ucw-gadgets/usb-rs485_switch/README.md

# usb-rs485_switch
8x RS-485 switch and USB convertor
