ucw-gadgets/usb-rs485_switch/hw/usb-rs485_switch/usb-rs485_switch.kicad_pcb

## KiCad design hw/usb-rs485_switch/usb-rs485_switch.kicad_pcb (2022-01-27)

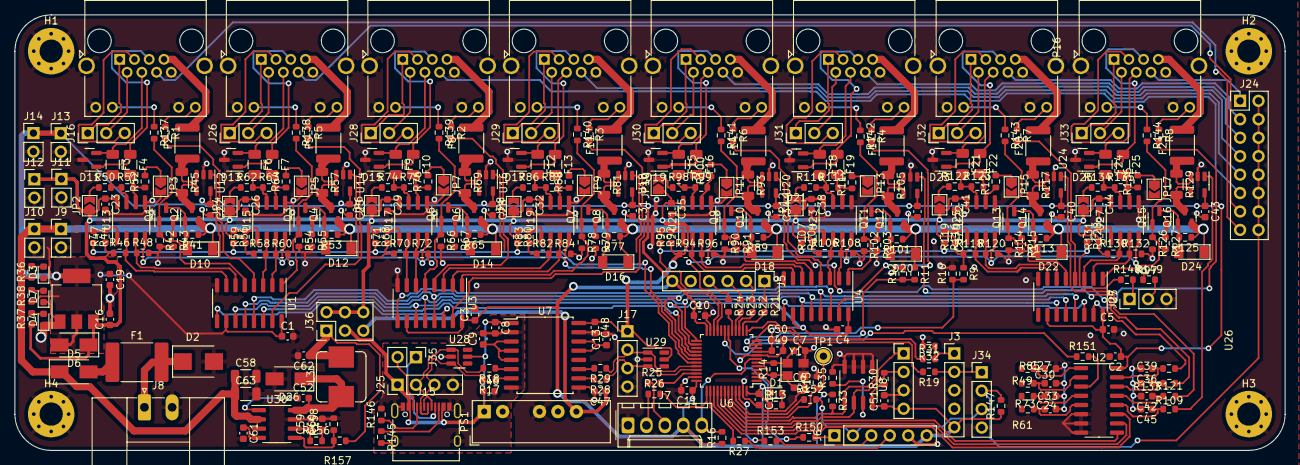
[picture p1: board usb-rs485_switch.kicad_pcb from above]

Board: 2 copper layers, 175.0 x 60.0 mm, 357 parts (0 on the bottom side), 279 nets.

Parts:
C1, C2, C3, C4, C5, C8, C9, C10, C11, C12, C13, C22, C23, C24, C25, C26, C27, C28, C29, C30, C31, C32, C33, C34, C35, C36, C37, C38, C39, C40, C41, C42, C43, C44, C45, C48, C49, C51, C52: 100n; C_0603_1608Metric
C6, C7: C; C_0603_1608Metric
C16, C47: 10u; C_0603_1608Metric
C19: 22u; C_0603_1608Metric
C46: 4u7; C_0603_1608Metric
C50: 1u; C_0603_1608Metric
C58, C63: 4u7/50V; C_1206_3216Metric
C59, C61: 8.2n; C_0603_1608Metric
C60: 22n; C_0603_1608Metric
C62: 22u/6.3V X5R; C_0603_1608Metric
D1: USR_LED; LED_0603_1608Metric
D2: SM6T27A; D_SMB
D3: VCC_LED; LED_0603_1608Metric
D4: 5V_LED; LED_0603_1608Metric
D5, D6: SS54; D_SMA
D7: 3V3_LED; LED_0603_1608Metric
D10, D12, D14, D16, D18, D20, D22, D24: ZMM5V6; D_MiniMELF
D11, D13, D15, D17, D19, D21, D23, D25: PSM712-LF-T7; SOT-23
D26: SS14; D_SMA
F1: Polyfuse; Fuse_2920_7451Metric
F2, F5, F8, F11, F14, F17, F20, F23: BSMD1812-110-33V; Fuse_1812_4532Metric
F3, F4, F6, F7, F9, F10, F12, F13, F15, F16, F18, F19, F21, F22, F24, F25: BSMD1206-010-60V; Fuse_1206_3216Metric
H1, H2, H3, H4: MountingHole_Pad; MountingHole_3.2mm_M3_Pad_Via
J1, J2, J18, J19, J20, J21, J22, J23: RJ45_LED_Shielded; RJ45_Amphenol_RJHSE538X
J3: USART2; PinHeader_1x05_P2.54mm_Vertical
J4: I2C; PinHeader_1x04_P2.54mm_Vertical
J5: SPI; PinHeader_1x06_P2.54mm_Vertical
J6: GPIO; PinHeader_1x06_P2.54mm_Vertical
J7: PROG; Molex_KK-254_AE-6410-05A_1x05_P2.54mm_Vertical
J8: POWER; PhoenixContact_MC_1,5_2-GF-3.81_1x02_P3.81mm_Horizontal_Thr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
J9: VCC_OUT1; PinHeader_1x02_P2.54mm_Vertical
J10: VCC_OUT2; PinHeader_1x02_P2.54mm_Vertical
J11: 5V_OUT1; PinHeader_1x02_P2.54mm_Vertical
J12: 5V_OUT2; PinHeader_1x02_P2.54mm_Vertical
J13: 3V_OUT1; PinHeader_1x02_P2.54mm_Vertical
J14: 3V3_OUT2; PinHeader_1x02_P2.54mm_Vertical
J15: MC-107DM; USB_C_Receptacle_XKB_U262-16XN-4BVC11
J16: RES1; PinHeader_1x03_P2.54mm_Vertical
J17: USB_NONISO; PinHeader_1x04_P2.54mm_Vertical
J24: 1WIRE_CHANNELS; PinHeader_2x08_P2.54mm_Vertical
J25: USB_ISO; PinHeader_1x04_P2.54mm_Vertical
J26: RES2; PinHeader_1x03_P2.54mm_Vertical
J27: USART3; PinHeader_1x03_P2.54mm_Vertical
J28: RES3; PinHeader_1x03_P2.54mm_Vertical
J29: RES4; PinHeader_1x03_P2.54mm_Vertical
J30: RES5; PinHeader_1x03_P2.54mm_Vertical
J31: RES6; PinHeader_1x03_P2.54mm_Vertical
J32: RES7; PinHeader_1x03_P2.54mm_Vertical
J33: RES8; PinHeader_1x03_P2.54mm_Vertical
J34: 1WIRE_SELECT; PinHeader_1x04_P2.54mm_Vertical
J35: USB-C_SBU; PinHeader_1x02_P2.54mm_Vertical
J36: PWR_SELECT; PinHeader_2x03_P2.54mm_Vertical
JP2, JP3, JP4, JP5, JP6, JP7, JP8, JP9, JP10, JP11, JP12, JP13, JP14, JP15, JP16, JP17: SolderJumper_2_Open; SolderJumper-2_P1.3mm_Open_TrianglePad1.0x1.5mm
L3: 47u; L_Bourns_SRP7028A_7.3x6.6mm
PS1: IA0505S; Converter_DCDC_XP_POWER-IAxxxxS_THT
Q1, Q3, Q5, Q7, Q9, Q11, Q13, Q15: MMBT5551; SOT-23
Q2, Q4, Q6, Q8, Q10, Q12, Q14, Q16: Si2301CDS; SOT-23
R1, R2, R3, R4, R5, R6, R7, R8, R41, R53, R65, R77, R89, R101, R113, R125: 1k; R_0603_1608Metric
R9, R10, R11, R12, R13, R14, R15, R16, R31, R32, R35, R36, R37, R38, R148, R149, R156, R157, R158: R; R_0603_1608Metric
R17, R18, R28, R29: 24R; R_0603_1608Metric
R19, R21, R22, R23, R24, R25, R26, R27, R44, R56, R68, R80, R92, R104, R116, R128, R150, R151, R152, R153: 330R; R_0603_1608Metric
R30, R33, R147: 4k7; R_0603_1608Metric
R42, R46, R47, R48, R54, R58, R59, R60, R66, R70, R71, R72, R78, R82, R83, R84, R90, R94, R95, R96, R102, R106, R107, R108, R114, R118, R119, R120, R126, R130, R131, R132: 10k; R_0603_1608Metric
R43, R55, R67, R79, R91, R103, R115, R127, R137, R138, R139, R140, R141, R142, R143, R144: 2k7; R_0603_1608Metric
R45, R57, R69, R81, R93, R105, R117, R129: 0R1; R_1206_3216Metric
R49, R61, R73, R85, R97, R109, R121, R133: 100k; R_0603_1608Metric
R50, R52, R62, R64, R74, R76, R86, R88, R98, R100, R110, R112, R122, R124, R134, R136: 720R; R_0603_1608Metric
R51, R63, R75, R87, R99, R111, R123, R135: 120R; R_0603_1608Metric
R145, R146: 5k1; R_0603_1608Metric
TP1: BOOT0; TestPoint_THTPad_D2.0mm_Drill1.0mm
U1, U3, U4, U5: 74HC595; SOIC-16_3.9x9.9mm_P1.27mm
U2: CD4051B; SOIC-16_3.9x9.9mm_P1.27mm
U6: STM32F103C8Tx; LQFP-48_7x7mm_P0.5mm
U7: ADUM4160; SOIC-16W_7.5x10.3mm_P1.27mm
U8: M24C01-WMN; SOIC-8_3.9x4.9mm_P1.27mm
U11: AMS1117-3.3; SOT-223-3_TabPin2
U12, U14, U16, U18, U20, U22, U24, U26: INA180A1; SOT-23-5
U13, U15, U17, U19, U21, U23, U25, U27: MAX485E; SOIC-8_3.9x4.9mm_P1.27mm
U28, U29: SRV05-4; SOT-23-6
U30: TPS54331; SOIC-8_3.9x4.9mm_P1.27mm
Y1: Crystal_GND23; Crystal_SMD_3225-4Pin_3.2x2.5mm

Connections:
+3V3: C1.1, C2.1, C3.1, C4.1, C5.1, C10.1, C11.1, C12.1, C19.1, C22.1, C25.1, C28.1, C31.1, C34.1, C37.1, C40.1, C43.1, C49.1, C50.1, C51.1, D6.2 (A), J3.5, J4.4, J5.6, J6.6, J7.4, J13.1, J14.1, R13.1, R16.1, R30.1, R33.1, R38.1, R147.1, U1.10 (~SRCLR), U1.16 (VCC), U2.16 (VDD), U3.10 (~SRCLR), U3.16 (VCC), U4.10 (~SRCLR), U4.16 (VCC), U5.10 (~SRCLR), U5.16 (VCC), U6.9 (VDDA), U6.24 (VDD), U6.36 (VDD), U6.48 (VDD), U8.8 (VCC), U11.2 (VO), U12.5 (VS), U14.5 (VS), U16.5 (VS), U18.5 (VS), U20.5 (VS), U22.5 (VS), U24.5 (VS), U26.5 (VS)
+5V: C16.1, C23.1, C26.1, C29.1, C32.1, C35.1, C38.1, C41.1, C44.1, C48.1, D6.1 (K), J11.1, J12.1, J17.1, J36.2, J36.4, J36.6, JP2.1 (A), JP4.1 (A), JP6.1 (A), JP8.1 (A), JP10.1 (A), JP12.1 (A), JP14.1 (A), JP16.1 (A), R9.1, R37.1, R46.1, R47.1, R58.1, R59.1, R70.1, R71.1, R82.1, R83.1, R94.1, R95.1, R106.1, R107.1, R118.1, R119.1, R130.1, R131.1, U7.16 (VBUS2), U11.3 (VI), U13.8 (VCC), U15.8 (VCC), U17.8 (VCC), U19.8 (VCC), U21.8 (VCC), U23.8 (VCC), U25.8 (VCC), U27.8 (VCC), U29.5 (VP)
/1WIRE: J24.2, J24.4, J24.6, J24.8, J24.10, J24.12, J24.14, J24.16, J34.2, R147.2
/1WIRE1: J1.6, J24.15
/1WIRE2: J2.6, J24.13
/1WIRE3: J18.6, J24.11
/1WIRE4: J19.6, J24.9
/1WIRE5: J20.6, J24.7
/1WIRE6: J21.6, J24.5
/1WIRE7: J22.6, J24.3
/1WIRE8: J23.6, J24.1
/5V_DCDC: C62.1, J36.1, L3.2, R157.1
/5V_SENSE: R9.2, R10.1, U6.11 (PA1)
/5V_USB_ISO: C47.1, J36.5, PS1.6 (+Vout)
/GPIO0: J6.1, R150.2
/GPIO1: J6.2, J34.3, R152.2
/GPIO2: J6.3, R153.2
/GPIO3: J6.4, R27.1
/I2C1_SCL: J4.2, R30.2, U6.42 (PB6), U8.6 (SCL)
/I2C1_SDA: J4.1, R33.2, U6.43 (PB7), U8.5 (SDA)
/I_SENSE: R151.2, U2.3 (X)
/I_SENSE1: C24.1, R49.1, U2.1 (X4)
/I_SENSE2: C27.1, R61.1, U2.5 (X5)
/I_SENSE3: C30.1, R73.1, U2.2 (X6)
/I_SENSE4: C33.1, R85.1, U2.4 (X7)
/I_SENSE5: C36.1, R97.1, U2.15 (X2)
/I_SENSE6: C39.1, R109.1, U2.14 (X1)
/I_SENSE7: C42.1, R121.1, U2.13 (X0)
/I_SENSE8: C45.1, R133.1, U2.12 (X3)
/I_SEN_A: U2.11 (A), U6.39 (PB3)
/I_SEN_B: U2.10 (B), U6.40 (PB4)
/I_SEN_C: U2.9 (C), U6.41 (PB5)
/LED_G1: J1.12, R1.1
/LED_G2: J2.12, R5.1
/LED_G3: J18.12, R2.1
/LED_G4: J19.12, R3.1
/LED_G5: J20.12, R6.1
/LED_G6: J21.12, R4.1
/LED_G7: J22.12, R7.1
/LED_G8: J23.12, R8.1
/NRST: J7.5, R16.2, U6.7 (NRST)
/PWR_EN1: Q1.1 (B), R42.1, R137.2, U1.5 (QF)
/PWR_EN2: Q3.1 (B), R54.1, R138.2, U1.1 (QB)
/PWR_EN3: Q5.1 (B), R66.1, R139.2, U3.5 (QF)
/PWR_EN4: Q7.1 (B), R78.1, R140.2, U3.1 (QB)
/PWR_EN5: Q9.1 (B), R90.1, R141.2, U4.5 (QF)
/PWR_EN6: Q11.1 (B), R102.1, R142.2, U4.1 (QB)
/PWR_EN7: Q13.1 (B), R114.1, R143.2, U5.5 (QF)
/PWR_EN8: Q15.1 (B), R126.1, R144.2, U5.1 (QB)
/RS485 Line driver/A: D11.1 (A1), F4.1, J1.5
/RS485 Line driver/B: D11.2 (A2), F3.1, J1.4
/RS485 Line driver/PWR_OUT: F2.2, J1.7
/SPI1_MISO: J5.3, R23.1
/SPI1_MOSI: J5.4, R24.1
/SPI1_SCK: J5.2, R22.1
/SPI2_MOSI: U1.14 (SER), U6.28 (PB15)
/SPI2_SCK: U1.11 (SRCLK), U3.11 (SRCLK), U4.11 (SRCLK), U5.11 (SRCLK), U6.26 (PB13)
/SPI2_STROBE: U1.12 (RCLK), U3.12 (RCLK), U4.12 (RCLK), U5.12 (RCLK), U6.25 (PB12)
/SWCLK: J7.2, R26.1
/SWDIO: J7.3, R25.1
/TX_EN1: R48.1, U1.6 (QG), U13.3 (DE)
/TX_EN2: R60.1, U1.2 (QC), U15.3 (DE)
/TX_EN3: R72.1, U3.6 (QG), U17.3 (DE)
/TX_EN4: R84.1, U3.2 (QC), U19.3 (DE)
/TX_EN5: R96.1, U4.6 (QG), U21.3 (DE)
/TX_EN6: R108.1, U4.2 (QC), U23.3 (DE)
/TX_EN7: R120.1, U5.6 (QG), U25.3 (DE)
/TX_EN8: R132.1, U5.2 (QC), U27.3 (DE)
/USART1_RX: R44.2, R56.2, R68.2, R80.2, U6.31 (PA10)
/USART1_TX: U6.30 (PA9), U13.4 (DI), U15.4 (DI), U17.4 (DI), U19.4 (DI)
/USART2_RX: R31.1, U6.13 (PA3)
/USART2_TX: J3.2, J34.1, R19.1
/USART3_RX: R92.2, R104.2, R116.2, R128.2, R148.1, U6.22 (PB11)
/USART3_TX: R149.1, U6.21 (PB10), U21.4 (DI), U23.4 (DI), U25.4 (DI), U27.4 (DI)
/USB_DN: J17.2, R29.1, U6.32 (PA11), U29.1 (IO1)
/USB_DP: J17.3, R28.1, U6.33 (PA12), U29.3 (IO2)
/USB_IN_N: J15.A7 (D-), J15.B7 (D-), J25.2, R18.2, U28.1 (IO1)
/USB_IN_P: J15.A6 (D+), J15.B6 (D+), J25.3, R17.2, U28.3 (IO2)
/VCC_SENSE: R11.2, R12.1, U6.10 (PA0)
/sheet620AF7C7/A: D17.1 (A1), F13.1, J19.5
/sheet620AF7C7/B: D17.2 (A2), F12.1, J19.4
/sheet620AF7C7/PWR_OUT: F11.2, J19.7
/sheet620CBEF1/A: D19.1 (A1), F16.1, J20.5
/sheet620CBEF1/B: D19.2 (A2), F15.1, J20.4
/sheet620CBEF1/PWR_OUT: F14.2, J20.7
/sheet620CBEF2/A: D21.1 (A1), F19.1, J21.5
/sheet620CBEF2/B: D21.2 (A2), F18.1, J21.4
/sheet620CBEF2/PWR_OUT: F17.2, J21.7
/sheet620CBEF3/A: D23.1 (A1), F22.1, J22.5
/sheet620CBEF3/B: D23.2 (A2), F21.1, J22.4
/sheet620CBEF3/PWR_OUT: F20.2, J22.7
/sheet620CBEF4/A: D25.1 (A1), F25.1, J23.5
/sheet620CBEF4/B: D25.2 (A2), F24.1, J23.4
/sheet620CBEF4/PWR_OUT: F23.2, J23.7
/sheet6205AD21/A: D13.1 (A1), F7.1, J2.5
/sheet6205AD21/B: D13.2 (A2), F6.1, J2.4
/sheet6205AD21/PWR_OUT: F5.2, J2.7
/sheet62070CF7/A: D15.1 (A1), F10.1, J18.5
/sheet62070CF7/B: D15.2 (A2), F9.1, J18.4
/sheet62070CF7/PWR_OUT: F8.2, J18.7
/~RX_EN1: R46.2, U1.7 (QH), U13.2 (~RE)
/~RX_EN2: R58.2, U1.3 (QD), U15.2 (~RE)
/~RX_EN3: R70.2, U3.7 (QH), U17.2 (~RE)
/~RX_EN4: R82.2, U3.3 (QD), U19.2 (~RE)
/~RX_EN5: R94.2, U4.7 (QH), U21.2 (~RE)
/~RX_EN6: R106.2, U4.3 (QD), U23.2 (~RE)
/~RX_EN7: R118.2, U5.7 (QH), U25.2 (~RE)
/~RX_EN8: R130.2, U5.3 (QD), U27.2 (~RE)
/~SPI1_SS: J5.1, R21.1
/~SPI2_OE: U1.13 (~OE), U3.13 (~OE), U4.13 (~OE), U5.13 (~OE), U6.29 (PA8)
GND: C1.2, C2.2, C3.2, C4.2, C5.2, C6.2, C7.2, C10.2, C11.2, C12.2, C13.2, C16.2, C19.2, C22.2, C23.2, C24.2, C25.2, C26.2, C27.2, C28.2, C29.2, C30.2, C31.2, C32.2, C33.2, C34.2, C35.2, C36.2, C37.2, C38.2, C39.2, C40.2, C41.2, C42.2, C43.2, C44.2, C45.2, C47.2, C48.2, C49.2, C50.2, C51.2, C58.2, C59.2, C60.2, C61.2, C62.2, C63.2, D2.2 (A2), D3.1 (K), D4.1 (K), D7.1 (K), D11.3 (common), D13.3 (common), D15.3 (common), D17.3 (common), D19.3 (common), D21.3 (common), D23.3 (common), D25.3 (common), D26.2 (A), H1.1, H2.1, H3.1, H4.1, J1.8, J1.9, J1.11, J1.SH, J2.8, J2.9, J2.11, J2.SH, J3.3, J4.3, J5.5, J6.5, J7.1, J8.2, J9.2, J10.2, J11.2, J12.2, J13.2, J14.2, J17.4, J18.8, J18.9, J18.11, J18.SH, J19.8, J19.9, J19.11, J19.SH, J20.8, J20.9, J20.11, J20.SH, J21.8, J21.9, J21.11, J21.SH, J22.8, J22.9, J22.11, J22.SH, J23.8, J23.9, J23.11, J23.SH, J27.3, J34.4, JP3.2 (B), JP5.2 (B), JP7.2 (B), JP9.2 (B), JP11.2 (B), JP13.2 (B), JP15.2 (B), JP17.2 (B), PS1.4 (-Vout), R10.2, R12.2, R15.2, R32.2, R35.2, R42.2, R43.2, R48.2, R54.2, R55.2, R60.2, R66.2, R67.2, R72.2, R78.2, R79.2, R84.2, R90.2, R91.2, R96.2, R102.2, R103.2, R108.2, R114.2, R115.2, R120.2, R126.2, R127.2, R132.2, R158.2, U1.8 (GND), U2.6 (INH), U2.7 (VEE), U2.8 (VSS), U3.8 (GND), U4.8 (GND), U5.8 (GND), U6.8 (VSSA), U6.23 (VSS), U6.35 (VSS), U6.47 (VSS), U7.9 (GND2), U7.15 (GND2), U8.1 (E0), U8.2 (E1), U8.3 (E2), U8.4 (VSS), U11.1 (GND), U12.2 (GND), U13.5 (GND), U14.2 (GND), U15.5 (GND), U16.2 (GND), U17.5 (GND), U18.2 (GND), U19.5 (GND), U20.2 (GND), U21.5 (GND), U22.2 (GND), U23.5 (GND), U24.2 (GND), U25.5 (GND), U26.2 (GND), U27.5 (GND), U29.2 (VN), U30.7 (GND), Y1.2, Y1.3
GND2: C8.2, C9.2, C46.2, J15.A1 (GND), J15.A12 (GND), J15.B1 (GND), J15.B12 (GND), J15.S1 (SHIELD), J25.4, PS1.2 (-Vin), R145.2, R146.2, U7.2 (GND1), U7.8 (GND1), U28.2 (VN)
unnamed: C6.1, R14.1, U6.5 (PD0), Y1.1
unnamed: C7.1, R14.2, U6.6 (PD1), Y1.4
unnamed: C9.1, U7.3 (VDD1), U7.4 (PDEN), U7.5 (SPU)
unnamed: C13.1, U7.13 (SPD), U7.14 (VDD2)
unnamed: C52.2, D26.1 (K), L3.1, U30.8 (PH)
unnamed: C60.1, R156.2
unnamed: D1.1 (K), U6.2 (PC13)
unnamed: D1.2 (A), R13.2
unnamed: D2.1 (A1), F1.2, J8.1
unnamed: D3.2 (A), R36.2
unnamed: D4.2 (A), R37.2
unnamed: D5.2 (A), F1.1
unnamed: D7.2 (A), R38.2
unnamed: D10.2 (A), Q1.3 (C), Q2.1 (G), R41.2
unnamed: D12.2 (A), Q3.3 (C), Q4.1 (G), R53.2
unnamed: D14.2 (A), Q5.3 (C), Q6.1 (G), R65.2
unnamed: D16.2 (A), Q7.3 (C), Q8.1 (G), R77.2
unnamed: D18.2 (A), Q9.3 (C), Q10.1 (G), R89.2
unnamed: D20.2 (A), Q11.3 (C), Q12.1 (G), R101.2
unnamed: D22.2 (A), Q13.3 (C), Q14.1 (G), R113.2
unnamed: D24.2 (A), Q15.3 (C), Q16.1 (G), R125.2
unnamed: F2.1, R45.1, U12.3 (+)
unnamed: F3.2, R50.2, R51.1, U13.7 (B)
unnamed: F4.2, R51.2, R52.1, U13.6 (A)
unnamed: F5.1, R57.1, U14.3 (+)
unnamed: F6.2, R62.2, R63.1, U15.7 (B)
unnamed: F7.2, R63.2, R64.1, U15.6 (A)
unnamed: F8.1, R69.1, U16.3 (+)
unnamed: F9.2, R74.2, R75.1, U17.7 (B)
unnamed: F10.2, R75.2, R76.1, U17.6 (A)
unnamed: F11.1, R81.1, U18.3 (+)
unnamed: F12.2, R86.2, R87.1, U19.7 (B)
unnamed: F13.2, R87.2, R88.1, U19.6 (A)
unnamed: F14.1, R93.1, U20.3 (+)
unnamed: F15.2, R98.2, R99.1, U21.7 (B)
unnamed: F16.2, R99.2, R100.1, U21.6 (A)
unnamed: F17.1, R105.1, U22.3 (+)
unnamed: F18.2, R110.2, R111.1, U23.7 (B)
unnamed: F19.2, R111.2, R112.1, U23.6 (A)
unnamed: F20.1, R117.1, U24.3 (+)
unnamed: F21.2, R122.2, R123.1, U25.7 (B)
unnamed: F22.2, R123.2, R124.1, U25.6 (A)
unnamed: F23.1, R129.1, U26.3 (+)
unnamed: F24.2, R134.2, R135.1, U27.7 (B)
unnamed: F25.2, R135.2, R136.1, U27.6 (A)
unnamed: J1.1, J16.1
unnamed: J1.2, J16.2
unnamed: J1.3, J16.3
unnamed: J1.10, R137.1
unnamed: J2.1, J26.1
unnamed: J2.2, J26.2
unnamed: J2.3, J26.3
unnamed: J2.10, R138.1
unnamed: J3.1, R31.2, R32.1
unnamed: J15.A5 (CC1), R146.1
unnamed: J15.A8 (SBU1), J35.1
unnamed: J15.B5 (CC2), R145.1
unnamed: J15.B8 (SBU2), J35.2
unnamed: J18.1, J28.1
unnamed: J18.2, J28.2
unnamed: J18.3, J28.3
unnamed: J18.10, R139.1
unnamed: J19.1, J29.1
unnamed: J19.2, J29.2
unnamed: J19.3, J29.3
unnamed: J19.10, R140.1
unnamed: J20.1, J30.1
unnamed: J20.2, J30.2
unnamed: J20.3, J30.3
unnamed: J20.10, R141.1
unnamed: J21.1, J31.1
unnamed: J21.2, J31.2
unnamed: J21.3, J31.3
unnamed: J21.10, R142.1
unnamed: J22.1, J32.1
unnamed: J22.2, J32.2
unnamed: J22.3, J32.3
unnamed: J22.10, R143.1
unnamed: J23.1, J33.1
unnamed: J23.2, J33.2
unnamed: J23.3, J33.3
unnamed: J23.10, R144.1
unnamed: J27.1, R148.2
unnamed: J27.2, R149.2
unnamed: JP2.2 (B), R50.1
unnamed: JP3.1 (A), R52.2
unnamed: JP4.2 (B), R62.1
unnamed: JP5.1 (A), R64.2
unnamed: JP6.2 (B), R74.1
unnamed: JP7.1 (A), R76.2
unnamed: JP8.2 (B), R86.1
unnamed: JP9.1 (A), R88.2
unnamed: JP10.2 (B), R98.1
unnamed: JP11.1 (A), R100.2
unnamed: JP12.2 (B), R110.1
unnamed: JP13.1 (A), R112.2
unnamed: JP14.2 (B), R122.1
unnamed: JP15.1 (A), R124.2
unnamed: JP16.2 (B), R134.1
unnamed: JP17.1 (A), R136.2
unnamed: Q1.2 (E), R43.1
unnamed: Q2.3 (D), R45.2, U12.4 (-)
unnamed: Q3.2 (E), R55.1
unnamed: Q4.3 (D), R57.2, U14.4 (-)
unnamed: Q5.2 (E), R67.1
unnamed: Q6.3 (D), R69.2, U16.4 (-)
unnamed: Q7.2 (E), R79.1
unnamed: Q8.3 (D), R81.2, U18.4 (-)
unnamed: Q9.2 (E), R91.1
unnamed: Q10.3 (D), R93.2, U20.4 (-)
unnamed: Q11.2 (E), R103.1
unnamed: Q12.3 (D), R105.2, U22.4 (-)
unnamed: Q13.2 (E), R115.1
unnamed: Q14.3 (D), R117.2, U24.4 (-)
unnamed: Q15.2 (E), R127.1
unnamed: Q16.3 (D), R129.2, U26.4 (-)
unnamed: R7.2, U5.4 (QE)
unnamed: R8.2, U5.15 (QA)
unnamed: R15.1, TP1.1, U6.44 (BOOT0)
unnamed: R17.1, U7.7 (UD+)
unnamed: R18.1, U7.6 (UD-)
unnamed: R19.2, U6.12 (PA2)
unnamed: R21.2, U6.14 (PA4)
unnamed: R22.2, U6.15 (PA5)
unnamed: R23.2, U6.16 (PA6)
unnamed: R24.2, U6.17 (PA7)
unnamed: R25.2, U6.34 (PA13)
unnamed: R26.2, U6.37 (PA14)
unnamed: R27.2, U6.38 (PA15)
unnamed: R28.2, U7.10 (DD+)
unnamed: R29.2, U7.11 (DD-)
unnamed: R35.1, U8.7 (~WC)
unnamed: R44.1, R47.2, U13.1 (RO)
unnamed: R49.2, U12.1
unnamed: R56.1, R59.2, U15.1 (RO)
unnamed: R61.2, U14.1
unnamed: R68.1, R71.2, U17.1 (RO)
unnamed: R73.2, U16.1
unnamed: R80.1, R83.2, U19.1 (RO)
unnamed: R85.2, U18.1
unnamed: R92.1, R95.2, U21.1 (RO)
unnamed: R97.2, U20.1
unnamed: R104.1, R107.2, U23.1 (RO)
unnamed: R109.2, U22.1
unnamed: R116.1, R119.2, U25.1 (RO)
unnamed: R121.2, U24.1
unnamed: R128.1, R131.2, U27.1 (RO)
unnamed: R133.2, U26.1
unnamed: R150.1, U6.18 (PB0)
unnamed: R151.1, U6.19 (PB1)
unnamed: R152.1, U6.45 (PB8)
unnamed: R153.1, U6.46 (PB9)
unnamed: R1.2, U1.4 (QE)
unnamed: U1.9 (QH'), U3.14 (SER)
unnamed: R5.2, U1.15 (QA)
unnamed: R2.2, U3.4 (QE)
unnamed: R3.2, U3.15 (QA)
unnamed: R6.2, U4.4 (QE)
unnamed: U3.9 (QH'), U4.14 (SER)
unnamed: R4.2, U4.15 (QA)
unnamed: U4.9 (QH'), U5.14 (SER)
unnamed: C52.1, U30.1 (BOOT)
unnamed: C61.1, U30.4 (SS)
unnamed: R157.2, R158.1, U30.5 (VSENSE)
unnamed: C59.1, R156.1, U30.6 (COMP)
VBUS: C8.1, C46.1, J15.A4 (VBUS), J15.A9 (VBUS), J15.B4 (VBUS), J15.B9 (VBUS), J25.1, J36.3, PS1.1 (+Vin), U7.1 (VBUS1), U28.5 (VP)
VCC: C58.1, C63.1, D5.1 (K), D10.1 (K), D12.1 (K), D14.1 (K), D16.1 (K), D18.1 (K), D20.1 (K), D22.1 (K), D24.1 (K), J9.1, J10.1, Q2.2 (S), Q4.2 (S), Q6.2 (S), Q8.2 (S), Q10.2 (S), Q12.2 (S), Q14.2 (S), Q16.2 (S), R11.1, R36.1, R41.1, R53.1, R65.1, R77.1, R89.1, R101.1, R113.1, R125.1, U30.2 (VIN)
