ucw-gadgets/usb-rs485_switch/sw/daemon/control.c

/*
 *	USB-RS485 Switch Daemon -- Control Commands
 *
 *	(c) 2022--2023 Martin Mares <mj@ucw.cz>
 *
 *	Based on parts of the MODBUS module from stm32lib.
 */

#undef LOCAL_DEBUG

#include "daemon.h"
#include "control.h"

#include <string.h>
#include <ucw/unaligned.h>

// States of processing a control message
enum control_state {
	CSTATE_INIT,
	CSTATE_USB_READ,	// Waiting for data provided by USB
	CSTATE_USB_WRITE,	// Waiting for data sent to USB
	CSTATE_DONE,
};

// Context of processing a control message
struct ctrl {
	struct message *msg;
	struct port *for_port;
	enum control_state state;
	byte *rpos, *rend;
	byte *wpos, *wend;
	bool need_get_port_status;
	bool need_set_port_params;
	bool need_reset_port_stats;
};

#define CTRL_DBG(ctrl_ctx, fmt, ...) DBG("CTRL(%s): " fmt, ctrl_ctx->for_port->box->cf->name, ##__VA_ARGS__)

static uint read_remains(struct ctrl *c)
{
	return c->rend - c->rpos;
}

static byte read_byte(struct ctrl *c)
{
	return *c->rpos++;
}

static u16 read_u16(struct ctrl *c)
{
	byte hi = *c->rpos++;
	byte lo = *c->rpos++;
	return (hi << 8) | lo;
}

static void write_byte(struct ctrl *c, uint v)
{
	*c->wpos++ = v;
}

static void write_u16(struct ctrl *c, u16 v)
{
	write_byte(c, v >> 8);
	write_byte(c, v);
}

static uint write_remains(struct ctrl *c)
{
	return c->wend - c->wpos;
}

static void report_error(struct ctrl *c, uint code)
{
	// Discard the partially constructed body of the reply and rewrite the header
	CTRL_DBG(c, "Error %u", code);
	struct message *m = c->msg;
	m->reply[1] |= 0x80;
	m->reply[2] = code;
	c->wpos = m->reply + 3;
	c->state = CSTATE_DONE;
}

static uint u32_part(uint addr, u32 val)
{
	if (addr & 1)
		return val >> 16;
	else
		return val & 0xffff;
}

static bool check_input_register_addr(struct ctrl *c, uint addr)
{
	if (addr >= 1 && addr < URS485_IREG_MAX) {
		c->need_get_port_status = true;
		return true;
	}
	return false;
}

static uint get_input_register(struct ctrl *c, uint addr)
{
	struct port *port = c->for_port;

	switch (addr) {
		case URS485_IREG_CURRENT_SENSE:
			return port->current_sense;
		case URS485_IREG_CNT_BROADCASTS ... URS485_IREG_CNT_BROADCASTS_HI:
			return u32_part(addr, port->cnt_broadcasts);
		case URS485_IREG_CNT_UNICASTS ... URS485_IREG_CNT_UNICASTS_HI:
			return u32_part(addr, port->cnt_unicasts);
		case URS485_IREG_CNT_FRAME_ERRORS ... URS485_IREG_CNT_FRAME_ERRORS_HI:
			return u32_part(addr, port->cnt_frame_errors);
		case URS485_IREG_CNT_OVERSIZE_ERRORS ... URS485_IREG_CNT_OVERSIZE_ERRORS_HI:
			return u32_part(addr, port->cnt_oversize_errors);
		case URS485_IREG_CNT_UNDERSIZE_ERRORS ... URS485_IREG_CNT_UNDERSIZE_ERRORS_HI:
			return u32_part(addr, port->cnt_undersize_errors);
		case URS485_IREG_CNT_CRC_ERRORS ... URS485_IREG_CNT_CRC_ERRORS_HI:
			return u32_part(addr, port->cnt_crc_errors);
		case URS485_IREG_CNT_MISMATCH_ERRORS ... URS485_IREG_CNT_MISMATCH_ERRORS_HI:
			return u32_part(addr, port->cnt_mismatch_errors);
		case URS485_IREG_CNT_TIMEOUTS ... URS485_IREG_CNT_TIMEOUTS_HI:
			return u32_part(addr, port->cnt_timeouts);
		default:
			ASSERT(0);
	}
}

static bool check_holding_register_addr(struct ctrl *c UNUSED, uint addr)
{
	return (addr >= 1 && addr < URS485_HREG_CONFIG_MAX || URS485_HREG_RESET_STATS);
}

static uint get_holding_register(struct ctrl *c, uint addr)
{
	struct port *port = c->for_port;

	switch (addr) {
		case URS485_HREG_BAUD_RATE:
			return port->baud_rate / 100;
		case URS485_HREG_PARITY:
			return port->parity;
		case URS485_HREG_POWERED:
			return port->powered;
		case URS485_HREG_TIMEOUT:
			return port->request_timeout;
		case URS485_HREG_RESET_STATS:
			return 0;
		case URS485_HREG_DESCRIPTION_1 ... URS485_HREG_DESCRIPTION_4:
			return get_u16_be(&port->description[2*(addr - URS485_HREG_DESCRIPTION_1)]);
		default:
			ASSERT(0);
	}
}

static bool check_holding_register_write(struct ctrl *c UNUSED, uint addr, uint val)
{
	switch (addr) {
		case URS485_HREG_BAUD_RATE:
			return (val >= 12 && val <= 1152);
		case URS485_HREG_PARITY:
			return (val <= 2);
		case URS485_HREG_POWERED:
			return (val <= 1);
		case URS485_HREG_TIMEOUT:
			return (val >= 1 && val <= 65535);
		case URS485_HREG_DESCRIPTION_1 ... URS485_HREG_DESCRIPTION_4:
			for (uint i=0; i<2; i++) {
				uint x = (val >> (8*i)) & 0xff;
				if (x < 0x20 || x >= 0x7f)
					return 0;
			}
			return 1;
		case URS485_HREG_RESET_STATS:
			return true;
		default:
			return false;
	}
}

static void set_holding_register(struct ctrl *c, uint addr, uint val)
{
	struct port *port = c->for_port;

	switch (addr) {
		case URS485_HREG_BAUD_RATE:
			port->baud_rate = val * 100;
			c->need_set_port_params = true;
			break;
		case URS485_HREG_PARITY:
			port->parity = val;
			c->need_set_port_params = true;
			break;
		case URS485_HREG_POWERED:
			port->powered = val;
			c->need_set_port_params = true;
			break;
		case URS485_HREG_TIMEOUT:
			port->request_timeout = val;
			c->need_set_port_params = true;
			break;
		case URS485_HREG_DESCRIPTION_1 ... URS485_HREG_DESCRIPTION_4:
			put_u16_be(&port->description[2*(addr - URS485_HREG_DESCRIPTION_1)], val);
			persist_schedule_write(c->for_port->box);
			break;
		case URS485_HREG_RESET_STATS:
			if (val == 0xdead)
				c->need_reset_port_stats = true;
			break;
		default:
			ASSERT(0);
	}
}

static void func_read_registers(struct ctrl *c, bool holding)
{
	if (read_remains(c) < 4)
		return report_error(c, MODBUS_ERR_ILLEGAL_DATA_VALUE);

	uint start = read_u16(c);
	uint count = read_u16(c);

	uint bytes = 2*count;
	if (bytes + 1 > write_remains(c))
		return report_error(c, MODBUS_ERR_ILLEGAL_DATA_VALUE);

	switch (c->state) {
		case CSTATE_INIT:
			CTRL_DBG(c, "Read %s registers %u+%u", (holding ? "holding" : "input"), start, count);

			for (uint i = 0; i < count; i++)
				if (!(holding ? check_holding_register_addr : check_input_register_addr)(c, start + i))
					return report_error(c, MODBUS_ERR_ILLEGAL_DATA_ADDRESS);

			if (c->need_get_port_status) {
				if (!usb_submit_get_port_status(c->for_port))
					return report_error(c, MODBUS_ERR_SLAVE_DEVICE_FAILURE);
				c->state = CSTATE_USB_READ;
				return;
			}
			break;
		case CSTATE_USB_READ:
			break;
		default:
			ASSERT(0);
	}

	write_byte(c, bytes);
	for (uint i = 0; i < count; i++)
		write_u16(c, (holding ? get_holding_register : get_input_register)(c, start + i));

	c->state = CSTATE_DONE;
}

static bool finish_write(struct ctrl *c)
{
	// Fortunately, there is a gap between different kinds of registers,
	// so we never need to schedule multiple USB requests per MODBUS transaction.

	if (c->need_set_port_params) {
		persist_schedule_write(c->for_port->box);
		if (usb_submit_set_port_params(c->for_port)) {
			c->state = CSTATE_USB_WRITE;
			return true;
		}
		// If USB is not connected, parameter changes will apply after reconnect
	}

	if (c->need_reset_port_stats) {
		if (usb_submit_reset_port_stats(c->for_port)) {
			c->state = CSTATE_USB_WRITE;
			return true;
		}
	}

	return false;
}

static void func_write_single_register(struct ctrl *c)
{
	if (read_remains(c) < 4)
		return report_error(c, MODBUS_ERR_ILLEGAL_DATA_VALUE);

	uint addr = read_u16(c);
	uint value = read_u16(c);

	switch (c->state) {
		case CSTATE_INIT:
			CTRL_DBG(c, "Write single register %u=%u", addr, value);

			if (!check_holding_register_addr(c, addr))
				return report_error(c, MODBUS_ERR_ILLEGAL_DATA_ADDRESS);

			if (!check_holding_register_write(c, addr, value))
				return report_error(c, MODBUS_ERR_SLAVE_DEVICE_FAILURE);

			set_holding_register(c, addr, value);

			if (finish_write(c))
				return;
			break;
		case CSTATE_USB_WRITE:
			break;
		default:
			ASSERT(0);
	}

	write_u16(c, addr);
	write_u16(c, value);

	c->state = CSTATE_DONE;
}

static void func_write_multiple_registers(struct ctrl *c)
{
	if (read_remains(c) < 5)
		return report_error(c, MODBUS_ERR_ILLEGAL_DATA_VALUE);

	uint start = read_u16(c);
	uint count = read_u16(c);
	byte bytes = read_byte(c);

	if (read_remains(c) < bytes || bytes != 2*count)
		return report_error(c, MODBUS_ERR_ILLEGAL_DATA_VALUE);

	uint val[count];

	switch (c->state) {
		case CSTATE_INIT:
			CTRL_DBG(c, "Write multiple registers %u+%u", start, count);

			for (uint i = 0; i < count; i++) {
				if (!check_holding_register_addr(c, start + i))
					return report_error(c, MODBUS_ERR_ILLEGAL_DATA_ADDRESS);
				val[i] = read_u16(c);
			}

			for (uint i = 0; i < count; i++)
				if (!check_holding_register_write(c, start + i, val[i]))
					return report_error(c, MODBUS_ERR_SLAVE_DEVICE_FAILURE);

			for (uint i = 0; i < count; i++)
				set_holding_register(c, start + i, val[i]);

			if (finish_write(c))
				return;
			break;
		case CSTATE_USB_WRITE:
			break;
		default:
			ASSERT(0);
	}

	write_u16(c, start);
	write_u16(c, count);
	c->state = CSTATE_DONE;
}

enum modbus_id_object {
	MODBUS_ID_VENDOR_NAME,
	MODBUS_ID_PRODUCT_CODE,
	MODBUS_ID_MAJOR_MINOR_REVISION,
	MODBUS_ID_VENDOR_URL,
	MODBUS_ID_PRODUCT_NAME,
	MODBUS_ID_USER_APP_NAME,
	MODBUS_ID_MAX,
	MODBUS_ID_CUSTOM_SWITCH_NAME = 0x80,
	MODBUS_ID_CUSTOM_HW_SERIAL_NUMBER,
	MODBUS_ID_CUSTOM_HW_REVISION,
	MODBUS_ID_CUSTOM_MAX,
};

static const char * const modbus_id_strings[MODBUS_ID_MAX] = {
	[MODBUS_ID_VENDOR_NAME] = "United Computer Wizards",
	[MODBUS_ID_PRODUCT_CODE] = "URS-485",
	[MODBUS_ID_MAJOR_MINOR_REVISION] = DAEMON_VERSION,
	[MODBUS_ID_VENDOR_URL] = "https://www.ucw.cz/",
	[MODBUS_ID_PRODUCT_NAME] = "USB-to-RS485 Switch",
	[MODBUS_ID_USER_APP_NAME] = NULL,
};

static void func_encapsulated_interface_transport(struct ctrl *c)
{
	if (read_remains(c) < 3 ||
	    read_byte(c) != MODBUS_EIT_READ_DEVICE_IDENT)
		return report_error(c, MODBUS_ERR_ILLEGAL_DATA_VALUE);

	byte action = read_byte(c);
	byte id = read_byte(c);

	byte range_min, range_max;
	switch (action) {
		case 1:
			// Streaming access to basic identification
			range_min = MODBUS_ID_VENDOR_NAME;
			range_max = MODBUS_ID_MAJOR_MINOR_REVISION;
			break;
		case 2:
			// Streaming access to regular identification
			range_min = MODBUS_ID_VENDOR_URL;
			range_max = MODBUS_ID_USER_APP_NAME;
			break;
		case 3:
			// Streaming access to extended identification
			range_min = MODBUS_ID_CUSTOM_SWITCH_NAME;
			range_max = MODBUS_ID_CUSTOM_MAX - 1;
			break;
		case 4:
			// Individual access
			if (id < MODBUS_ID_MAX && modbus_id_strings[id] ||
			    id >= MODBUS_ID_CUSTOM_SWITCH_NAME && id < MODBUS_ID_CUSTOM_MAX)
				range_min = range_max = id;
			else
				return report_error(c, MODBUS_ERR_ILLEGAL_DATA_ADDRESS);
			break;
		default:
			return report_error(c, MODBUS_ERR_ILLEGAL_DATA_VALUE);
	}

	CTRL_DBG(c, "Identify: action=%d id=%d range=%d-%d", action, id, range_min, range_max);

	if (action != 4) {
		if (id < range_min || id > range_max)
			id = range_min;
	}

	write_byte(c, 0x0e);	// Repeat a part of the request
	write_byte(c, action);
	write_byte(c, 0x83);	// Conformity level: Extended identification, both stream and individual access supported

	byte *more_follows_at = c->wpos;
	write_byte(c, 0);	// More follows: so far not
	write_byte(c, 0);	// Next object ID: so far none
	write_byte(c, 0);	// Number of objects

	for (id = range_min; id <= range_max; id++) {
		const char *str;
		if (id < MODBUS_ID_MAX) {
			str = modbus_id_strings[id];
		} else {
			// XXX: Nobody can cross the boundary between standard and custom fields in on requests
			switch (id) {
				case MODBUS_ID_CUSTOM_SWITCH_NAME:
					str = c->for_port->box->cf->name;
					break;
				case MODBUS_ID_CUSTOM_HW_SERIAL_NUMBER:
					str = usb_get_serial_number(c->for_port->box);
					break;
				case MODBUS_ID_CUSTOM_HW_REVISION:
					str = usb_get_revision(c->for_port->box);
					break;
				default:
					str = NULL;
			}
		}
		if (!str)
			continue;

		uint len = strlen(str);
		uint remains = write_remains(c);
		if (len + 2 > remains) {
			// If it is the only object, cut it
			if (!more_follows_at[2]) {
				len = remains - 2;
			} else {
				// More follows, report the next ID
				more_follows_at[0] = 0xff;
				more_follows_at[1] = id;
				break;
			}
		}
		more_follows_at[2]++;
		write_byte(c, id);
		write_byte(c, len);
		memcpy(c->wpos, str, len);
		c->wpos += len;
	}

	c->state = CSTATE_DONE;
}

bool control_is_ready(struct box *box)
{
	// We currently process control messages one at a time
	return clist_empty(&box->control_messages_qn);
}

static void control_process_message(struct ctrl *c)
{
	// Called multiple times in different stages of message processing.
	// Each time, we read the message again.

	struct message *m = c->msg;
	c->rpos = m->request + 1;
	c->rend = m->request + m->request_size;

	m->reply[0] = m->request[0];
	m->reply[1] = m->request[1];
	c->wpos = m->reply + 2;
	c->wend = c->wpos + MODBUS_MAX_DATA_SIZE;

	uint func = read_byte(c);
	CTRL_DBG(c, "addr=%02x func=%02x state=%d", m->request[0], func, c->state);
	switch (func) {
		case MODBUS_FUNC_READ_HOLDING_REGISTERS:
			func_read_registers(c, true);
			break;
		case MODBUS_FUNC_READ_INPUT_REGISTERS:
			func_read_registers(c, false);
			break;
		case MODBUS_FUNC_WRITE_SINGLE_REGISTER:
			func_write_single_register(c);
			break;
		case MODBUS_FUNC_WRITE_MULTIPLE_REGISTERS:
			func_write_multiple_registers(c);
			break;
		case MODBUS_FUNC_ENCAPSULATED_INTERFACE_TRANSPORT:
			func_encapsulated_interface_transport(c);
			break;
		default:
			report_error(c, MODBUS_ERR_ILLEGAL_FUNCTION);
	}

	CTRL_DBG(c, "new_state=%d", c->state);
	if (c->state == CSTATE_DONE) {
		m->reply_size = c->wpos - m->reply;
		msg_send_reply(m);
	}
}

void control_submit_message(struct message *m)
{
	uint slave_addr = m->request[0];
	if (slave_addr < 1 || slave_addr > NUM_PORTS) {
		msg_send_error_reply(m, MODBUS_ERR_GATEWAY_PATH_UNAVAILABLE);
		return;
	}

	ASSERT(!m->ctrl);
	m->ctrl = xmalloc_zero(sizeof(struct ctrl));
	struct ctrl *c = m->ctrl;
	c->msg = m;
	c->for_port = &m->box->ports[slave_addr];

	c->state = CSTATE_INIT;
	c->need_get_port_status = false;
	c->need_set_port_params = false;
	c->need_reset_port_stats = false;

	control_process_message(c);
}

void control_usb_done(struct box *box)
{
	// Called when the USB module finishes processing of a submitted control request
	
	struct message *m = clist_head(&box->control_messages_qn);
	ASSERT(m);
	control_process_message(m->ctrl);
}
