ucw-gadgets/usb-rs485_switch/sw/daemon/daemon.h

/*
 *	USB-RS485 Switch Daemon
 *
 *	(c) 2022--2023 Martin Mares <mj@ucw.cz>
 */

#include <ucw/lib.h>
#include <ucw/clists.h>
#include <ucw/mainloop.h>

#include "../firmware/interface.h"
#include "modbus-proto.h"		// From stm32lib

#define DAEMON_VERSION "0.1"

#define NUM_PORTS 9			// 0 is the control port, 1-8 data ports
#define PORT_DESCRIPTION_SIZE 8

struct message {
	cnode queue_node;		// In either port->ready_messages or busy_messages
	cnode client_node;		// In one of client's lists or orphan_list
	struct box *box;
	struct client *client;		// NULL for orphaned messages (client disconnected)
	struct port *port;
	u16 client_transaction_id;
	u16 usb_message_id;
	uint request_size;
	byte request[2 + MODBUS_MAX_DATA_SIZE];	// As in struct urs485_message, without CRC
	uint reply_size;
	byte reply[2 + MODBUS_MAX_DATA_SIZE];
	struct ctrl *ctrl;		// Context of processing a control message
};

struct client {
	int id;				// ID used in messages (we use socket FDs for that)
	struct main_rec_io rio;		// TCP connection with the client
	struct box *box;
	struct port *port;
	clist rx_messages_cn;		// Received from the client, waiting for processing
	clist busy_messages_cn;		// Being processed
	uint queued_messages;		// Number of messages in either queue
};

struct port {
	struct box *box;
	uint port_number;
	uint phys_number;
	struct main_file listen_file;
	clist ready_messages_qn;	// Ready to be sent over USB

	// Port settings (including host representation of urs485_port_params)
	uint baud_rate;
	uint parity;			// URS485_PARITY_xxx
	uint powered;			// 0 or 1
	uint request_timeout;		// in milliseconds
	char description[PORT_DESCRIPTION_SIZE];

	// Port status (host representation of urs485_port_status)
	uint current_sense;
	uint cnt_broadcasts;
	uint cnt_unicasts;
	uint cnt_frame_errors;
	uint cnt_oversize_errors;
	uint cnt_undersize_errors;
	uint cnt_crc_errors;
	uint cnt_mismatch_errors;
	uint cnt_timeouts;
};

#define SERIAL_SIZE 16			// Including traling 0

struct box {				// Switch device
	cnode n;
	struct switch_config *cf;
	struct port ports[NUM_PORTS];
	clist busy_messages_qn;		// Sent over USB, waiting for reply
	clist control_messages_qn;	// Control messages being processed
	clist orphaned_messages_cn;	// Used instead of a client's list for orphaned messages
	struct main_hook sched_hook;
	struct main_timer persist_timer;
	struct usb_context *usb;
};

extern clist box_list;

/* urs485-daemon.c */

struct switch_config {
	cnode n;
	char *name;
	char *serial;
	uint tcp_port_base;
};

extern uint tcp_timeout;
extern uint log_connections;
extern uint max_queued_messages;
extern char *persistent_dir;
extern struct clist switch_configs;

extern uint log_type_client;
extern uint log_type_usb;

void persist_schedule_write(struct box *box);

/* client.c */

void net_init_port(struct port *port);

void msg_free(struct message *m);
void msg_send_reply(struct message *m);
void msg_send_error_reply(struct message *m, enum modbus_error err);

/* usb.c */

void usb_init(void);
bool usb_is_ready(struct box *box);
void usb_submit_message(struct message *m);
bool usb_submit_get_port_status(struct port *port);
bool usb_submit_set_port_params(struct port *port);
bool usb_submit_reset_port_stats(struct port *port);
char *usb_get_revision(struct box *box);
char *usb_get_serial_number(struct box *box);

/* control.c */

bool control_is_ready(struct box *box);
void control_submit_message(struct message *m);
void control_usb_done(struct box *box);
