ucw-gadgets/usb-rs485_switch/(commit log)

2021-06-12 WIP schematic
    [485_line_driver.sch, usb-rs485_switch.kicad_pcb, usb-rs485_switch.sch]
2021-11-23 Schematic WIP.
    [usb-rs485_switch.sch]
2021-12-22 Progress in schematic.
    [485_line_driver.sch, usb-rs485_switch.sch]
2021-12-28 Migration to KiCAD 6, finished schematic.
    [485_line_driver.kicad_sch, 485_line_driver.sch, usb-rs485_switch.kicad_sch, usb-rs485_switch.sch]
2022-01-03 Added 1wire and power selection jumpers.
    [usb-rs485_switch.kicad_sch]
2022-01-20 Assigned footprints, started routing.
    [485_line_driver.kicad_sch, usb-rs485_switch.kicad_pcb, usb-rs485_switch.kicad_sch]
2022-01-25 Routing in progress.
    [485_line_driver.kicad_sch, usb-rs485_switch.kicad_pcb, usb-rs485_switch.kicad_sch]
2022-01-27 Routing in progress...
    [485_line_driver.kicad_sch, usb-rs485_switch.kicad_pcb, usb-rs485_switch.kicad_sch]
2022-02-03 Removed unused DCDC, board labels.
    [485_line_driver.kicad_sch, usb-rs485_switch.kicad_sch]
2022-02-05 Final changes.
    [485_line_driver.kicad_sch, usb-rs485_switch.kicad_sch]
2022-03-12 mjtest: Manual control of port power
2022-06-22 mjtest: Testing ADC
2022-06-24 mjtest: Fix ADC tests
    [main.c]
2022-06-24 mjtest: Fix ADC clock
    [main.c]
2022-06-25 TODO: Brighten green LEDs
2022-06-25 TODO: Bugs in current measurement circuitry
2022-06-26 Firmware: USB bug fixes
    [firmware.h, interface.h, main.c, usb.c]
2022-06-26 Firmware: Fixed flow control problems
    [firmware.h, interface.h, usb.c]
2022-07-07 Firmware: Fix bugs in MODBUS direction switching
    [bus.c]
2022-07-07 Added an example MODBUS client device
2022-07-09 test-device: Fix Makefile
2022-07-12 Daemon: Preparing for support of multiple devices
    In most parts of the code, we use the "struct box" abstraction now.
    However, usb.c has to be rewritten to use USB hotplug before it can
    handle multiple boxes.
2022-07-12 Daemon: Support for multiple switches and USB hot-plug
2022-07-12 Firmware: Fix bug in sending of port statistics
    [usb.c]
2022-07-12 Daemon: Fix bug in tracking of busy messages at client's side
    [urs485-daemon.c]
2022-07-12 Daemon: Fix orphaning of messages
    [client.c]
2022-07-13 Daemon: Do not crash when trying to control a disconnected device
    [control.c, daemon.h, usb.c]
2022-07-15 Firmware: Fixed format of internal error replies
    [bus.c]
2022-07-15 Daemon: Fix ID conformity level
    [control.c]
2022-07-15 Fix numbering of ports
    [interface.h, urs485-daemon.c]
2022-07-17 Firmware: Proper inter-frame gaps
2022-07-18 Firmware: Activity LEDs
2022-07-18 Firmware: Shorter LED blinks
    [bus.c]
2022-07-18 Firmware: Resetting of port statistics
    [bus.c, firmware.h, interface.h, usb.c]
2022-07-18 Daemon: Upon USB error, cancel all transfers
    Otherwise, the RX transfer can hang indefinitely, preventing the
    broken state from being resolved.
    [usb.c]
2022-07-18 Daemon: Resetting of port statistics
    [control.c, control.h, daemon.h, usb.c]
2022-07-18 Utility: Resetting of port statistics
    [urs485-control.py]
2022-11-02 3d model of a box in OpenSCAD.
    [usb-rs485_switch.scad]
2022-11-05 Fix port cutout offsets.
    [usb-rs485_switch.scad]
2022-11-13 Updated shape of power connector.
    [usb-rs485_switch.scad]
2023-04-08 TODO: Visible power LEDs
2023-04-08 Firmware: Flash LEDs during initialization
    Power/debugging LEDs are not visible through the case,
    so let us do something visible during switch initialization.
2023-08-23 Utility: Bug fix for previous commit
    [urs485-control.py]
